mdhendri/Sprinkler/OpenSprinkler/JLPCB_BOM.xlsx

Comment | Designator | Footprint | JLCPCB Part #（optional）
10V 10uF X5R ±10% 0603 Multilayer Ceramic Capacitors MLCC - SMD/SMT ROHS | C7, C8, C9, C10, C13, C14, CS1 | 603 | C19702
 | C24 | 1206
4.7uF ±10% 0805 Multilayer Ceramic Capacitors MLCC - SMD/SMT ROHS | C25 | 805 | C576489
25V 22uF X5R ±20% 0805 Multilayer Ceramic Capacitors MLCC - SMD/SMT ROHS | C26 | 805 | C86816
1A 1kV 1.18V@2A SMA(DO-214AC) Diodes - General Purpose ROHS | D1, D2 | SMA(DO-214AC) | C47921
