mdhendri/Sprinkler/OpenSprinkler/OpenSprinkler.kicad_pcb

## KiCad design OpenSprinkler/OpenSprinkler.kicad_pcb (2025-02-17)

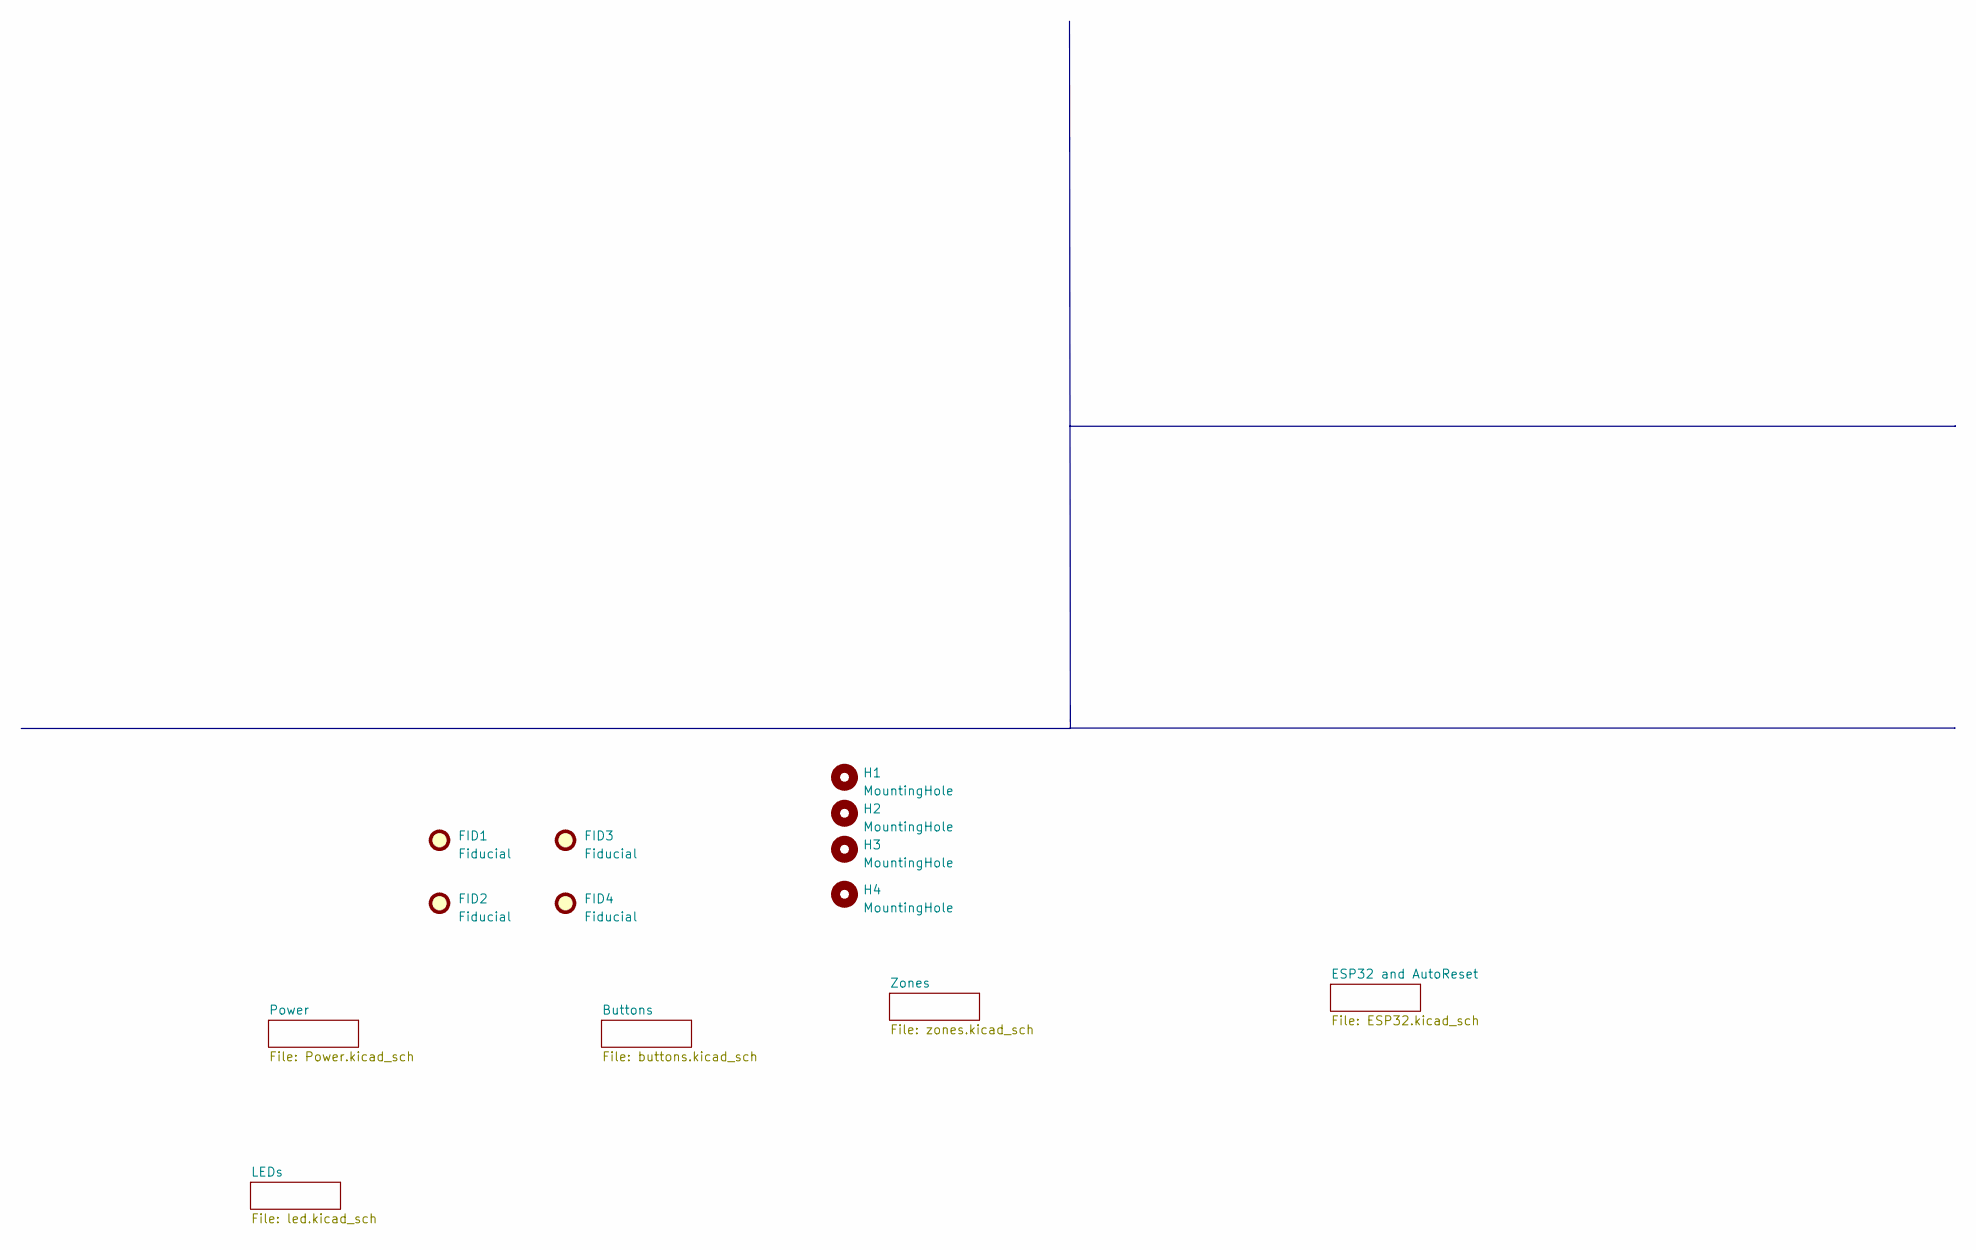
[picture p1: schematic OpenSprinkler.kicad_sch]

Parts:
FID1, FID2, FID3, FID4: Fiducial; Fiducial_0.5mm_Mask1.5mm
H1, H2, H3, H4: MountingHole; MountingHole_2.7mm

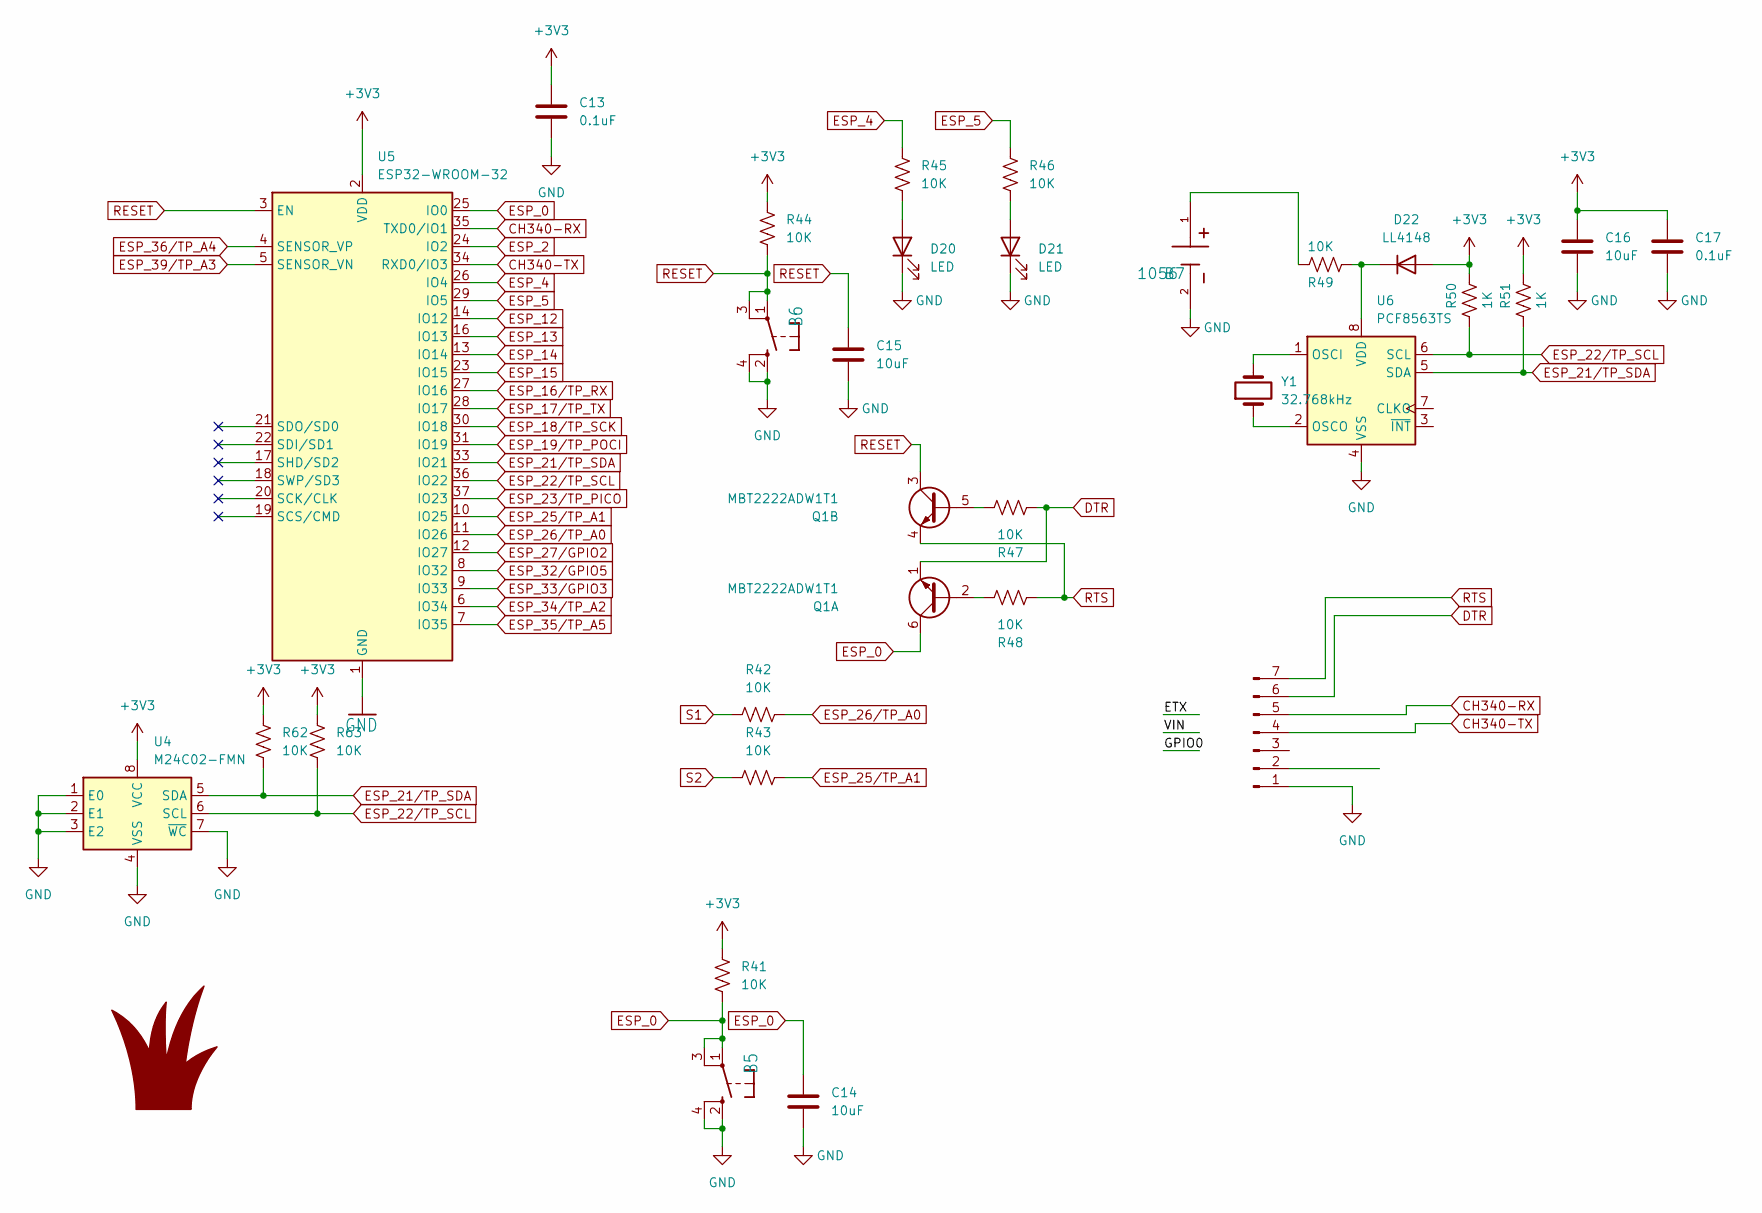
[picture p2: schematic ESP32.kicad_sch]

Parts:
B5, B6: SPST_TACTEVQQ2; SW_SPST_EVQQ2
B7: 1056; 1048P_KEY; PARTREV C
C13, C17: 0.1uF; C_0603_1608Metric_Pad1.08x0.95mm_HandSolder
C14, C15, C16: 10uF; C_0603_1608Metric_Pad1.08x0.95mm_HandSolder
D20, D21: LED; LED_0603_1608Metric_Pad1.05x0.95mm_HandSolder
D22: LL4148; D_MiniMELF
Q1: MBT2222ADW1T1; SOT-363_SC-70-6
R41, R42, R43, R44, R45, R46, R47, R48, R49, R62, R63: 10K; R_0603_1608Metric_Pad0.98x0.95mm_HandSolder
R50, R51: 1K; R_0603_1608Metric_Pad0.98x0.95mm_HandSolder
U4: M24C02-FMN; SOIC-8_3.9x4.9mm_P1.27mm
U5: ESP32-WROOM-32
U6: PCF8563TS; MSOP-8_3x3mm_P0.65mm
U$1: GOLDFINGER_2X3; PinHeader_1x07_P2.54mm_Vertical
Y1: 32.768kHz; XTAL_ECS-31B_ECS

Connections:
+3V3: C13.1, C16.1, C17.1, D22.2 (A), R41.1, R44.1, R50.1, R51.1, R62.1, R63.1, U4.8 (VCC), U5.2 (VDD); also elsewhere on the board
CH340-RX: U5.35 (TXD0/IO1), U$1.5
CH340-TX: U5.34 (RXD0/IO3), U$1.4
DTR: Q1.1 (E1), R47.1, U$1.6
ESP_0: B5.1, B5.3, C14.1, Q1.6 (C1), R41.2, U5.25 (IO0)
ESP_2: U5.24 (IO2)
ESP_4: R45.1, U5.26 (IO4)
ESP_5: R46.1, U5.29 (IO5)
ESP_12: U5.14 (IO12); also elsewhere on the board
ESP_13: U5.16 (IO13); also elsewhere on the board
ESP_14: U5.13 (IO14); also elsewhere on the board
ESP_15: U5.23 (IO15); also elsewhere on the board
ESP_16/TP_RX: U5.27 (IO16)
ESP_17/TP_TX: U5.28 (IO17)
ESP_18/TP_SCK: U5.30 (IO18)
ESP_19/TP_POCI: U5.31 (IO19)
ESP_21/TP_SDA: R51.2, R62.2, U4.5 (SDA), U5.33 (IO21), U6.5 (SDA); also elsewhere on the board
ESP_22/TP_SCL: R50.2, R63.2, U4.6 (SCL), U5.36 (IO22), U6.6 (SCL); also elsewhere on the board
ESP_23/TP_PICO: U5.37 (IO23)
ESP_25/TP_A1: R43.2, U5.10 (IO25)
ESP_26/TP_A0: R42.2, U5.11 (IO26)
ESP_27/GPIO2: U5.12 (IO27); also elsewhere on the board
ESP_32/GPIO5: U5.8 (IO32)
ESP_33/GPIO3: U5.9 (IO33)
ESP_34/TP_A2: U5.6 (IO34); also elsewhere on the board
ESP_35/TP_A5: U5.7 (IO35)
ESP_36/TP_A4: U5.4 (SENSOR_VP)
ESP_39/TP_A3: U5.5 (SENSOR_VN)
GND: B5.2, B5.4, B6.2, B6.4, B7.2, C13.2, C14.2, C15.2, C16.2, C17.2, D20.1 (K), D21.1 (K), U4.1 (E0), U4.2 (E1), U4.3 (E2), U4.4 (VSS), U4.7 (~WC), U5.1 (GND), U5.15 (GND), U5.38 (GND), U5.39 (GND), U6.4 (VSS), U$1.1; also elsewhere on the board
unnamed: B7.1, R49.1
unnamed: D20.2 (A), R45.2
unnamed: D21.2 (A), R46.2
unnamed: D22.1 (K), R49.2, U6.8 (VDD)
unnamed: Q1.2 (B1), R48.2
unnamed: Q1.5 (B2), R47.2
unnamed: U6.1 (OSCI), Y1.2
unnamed: U6.2 (OSCO), Y1.1
RESET: B6.1, B6.3, C15.1, Q1.3 (C2), R44.2, U5.3 (EN)
RTS: Q1.4 (E2), R48.1, U$1.7
S1: R42.1; also elsewhere on the board
S2: R43.1; also elsewhere on the board

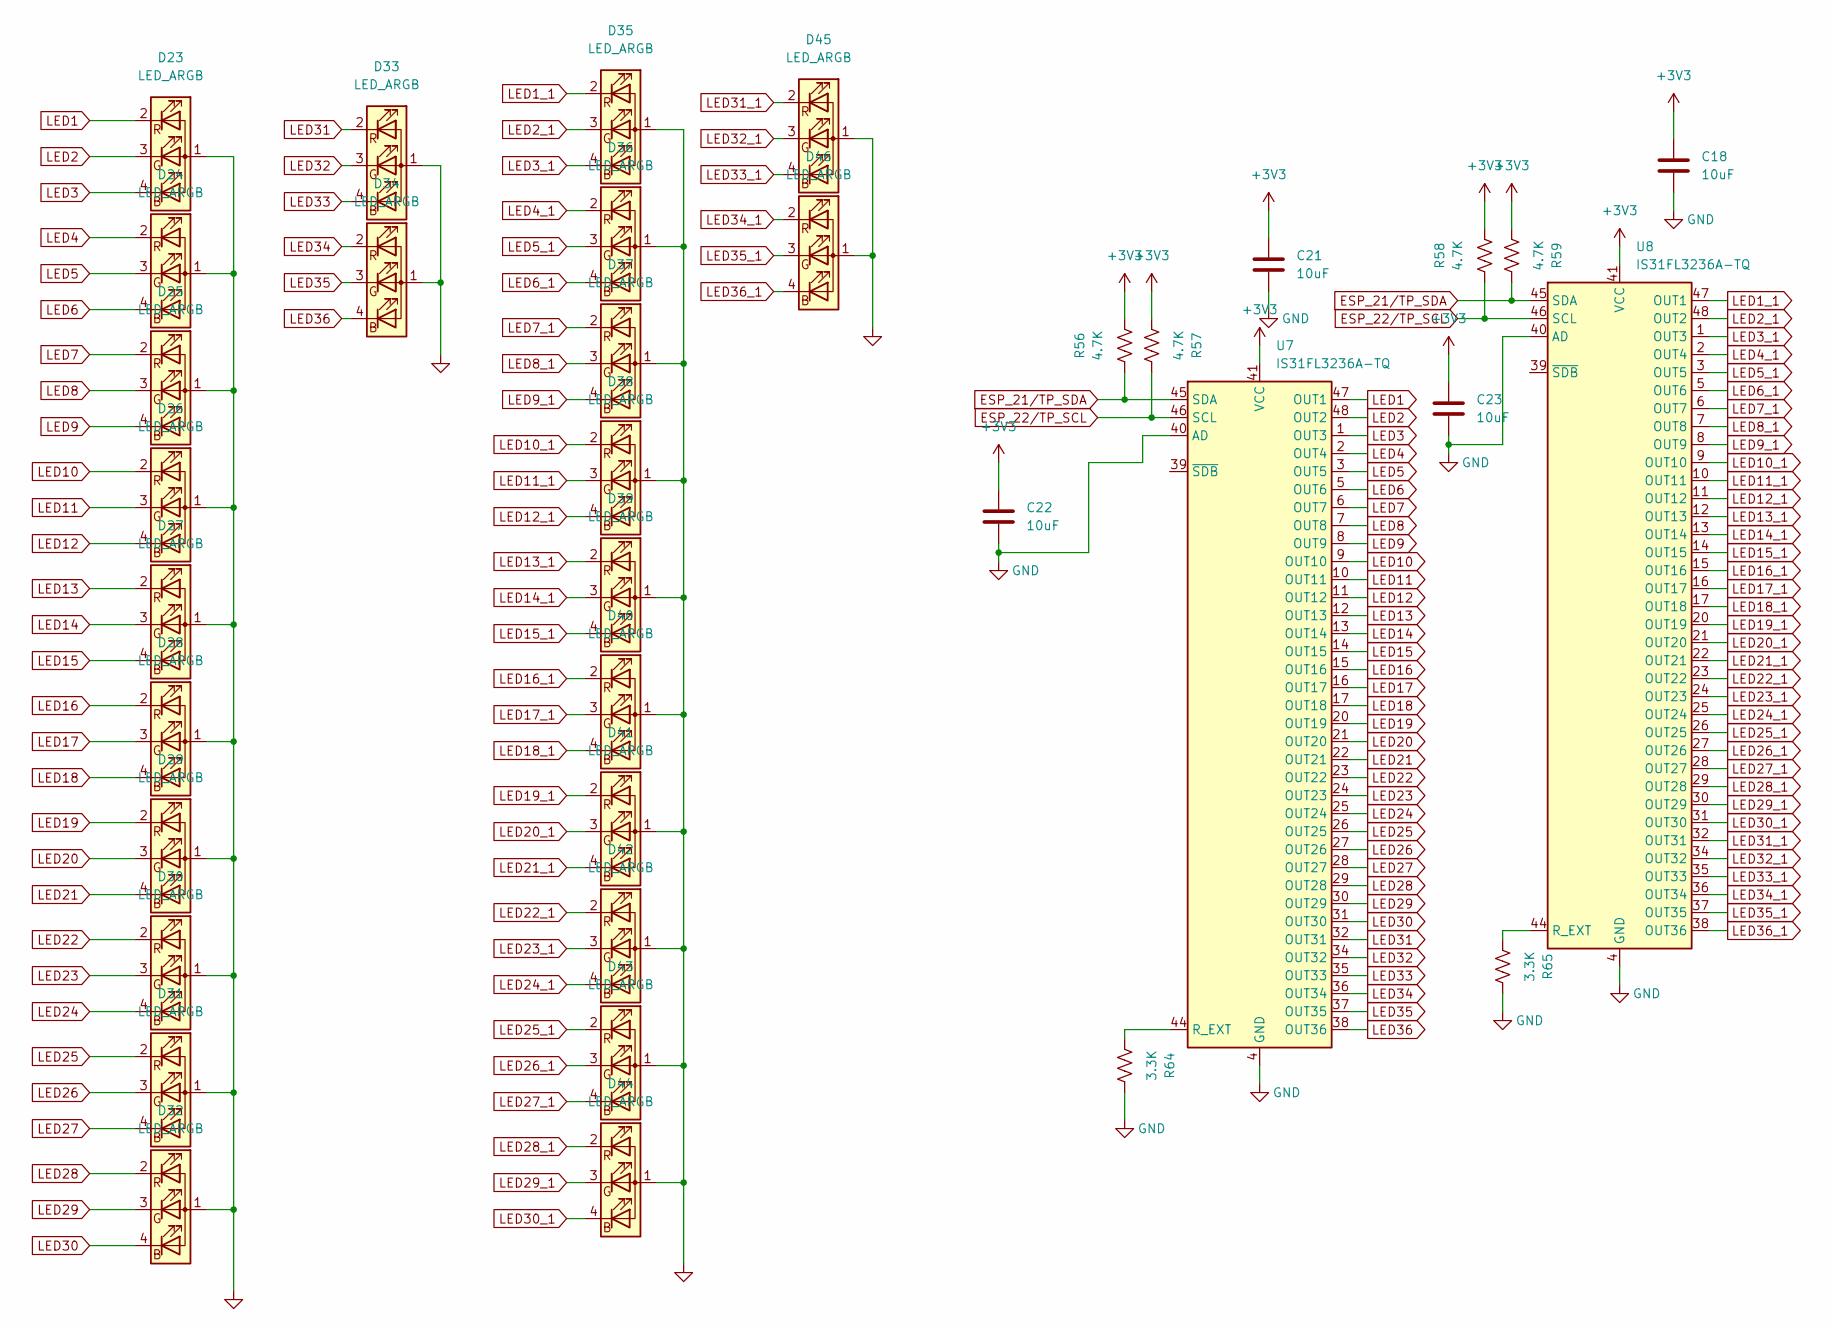
[picture p3: schematic led.kicad_sch]

Parts:
C18, C21, C22, C23: 10uF; C_0603_1608Metric_Pad1.08x0.95mm_HandSolder
D23, D24, D25, D26, D27, D28, D29, D30, D31, D32, D33, D34, D35, D36, D37, D38, D39, D40, D41, D42, D43, D44, D45, D46: LED_ARGB; LED_EASR3212RGBA0
R56, R57, R58, R59: 4.7K; R_0603_1608Metric_Pad0.98x0.95mm_HandSolder
R64, R65: 3.3K; R_0603_1608Metric_Pad0.98x0.95mm_HandSolder
U7, U8: IS31FL3236A-TQ; TQFP-48-1EP_7x7mm_P0.5mm_EP4.11x4.11mm

Connections:
+3V3: C18.1, C21.1, C22.1, C23.1, R56.2, R57.1, R58.2, R59.1, U7.41 (VCC), U8.41 (VCC); also elsewhere on the board
ESP_21/TP_SDA: R56.1, R59.2, U7.45 (SDA), U8.45 (SDA); also elsewhere on the board
ESP_22/TP_SCL: R57.2, R58.1, U7.46 (SCL), U8.46 (SCL); also elsewhere on the board
GND: C18.2, C21.2, C22.2, C23.2, D23.1 (A), D24.1 (A), D25.1 (A), D26.1 (A), D27.1 (A), D28.1 (A), D29.1 (A), D30.1 (A), D31.1 (A), D32.1 (A), D33.1 (A), D34.1 (A), D35.1 (A), D36.1 (A), D37.1 (A), D38.1 (A), D39.1 (A), D40.1 (A), D41.1 (A), D42.1 (A), D43.1 (A), D44.1 (A), D45.1 (A), D46.1 (A), R64.2, R65.2, U7.4 (GND), U7.18 (GND), U7.19 (GND), U7.33 (GND), U7.40 (AD), U7.42 (GND), U7.43 (GND), U7.49 (GND), U8.4 (GND), U8.18 (GND), U8.19 (GND), U8.33 (GND), U8.40 (AD), U8.42 (GND), U8.43 (GND), U8.49 (GND); also elsewhere on the board
LED1: D23.2 (RK), U7.47 (OUT1)
LED1_1: D35.2 (RK), U8.47 (OUT1)
LED2: D23.3 (GK), U7.48 (OUT2)
LED2_1: D35.3 (GK), U8.48 (OUT2)
LED3: D23.4 (BK), U7.1 (OUT3)
LED3_1: D35.4 (BK), U8.1 (OUT3)
LED4: D24.2 (RK), U7.2 (OUT4)
LED4_1: D36.2 (RK), U8.2 (OUT4)
LED5: D24.3 (GK), U7.3 (OUT5)
LED5_1: D36.3 (GK), U8.3 (OUT5)
LED6: D24.4 (BK), U7.5 (OUT6)
LED6_1: D36.4 (BK), U8.5 (OUT6)
LED7: D25.2 (RK), U7.6 (OUT7)
LED7_1: D37.2 (RK), U8.6 (OUT7)
LED8: D25.3 (GK), U7.7 (OUT8)
LED8_1: D37.3 (GK), U8.7 (OUT8)
LED9: D25.4 (BK), U7.8 (OUT9)
LED9_1: D37.4 (BK), U8.8 (OUT9)
LED10: D26.2 (RK), U7.9 (OUT10)
LED10_1: D38.2 (RK), U8.9 (OUT10)
LED11: D26.3 (GK), U7.10 (OUT11)
LED11_1: D38.3 (GK), U8.10 (OUT11)
LED12: D26.4 (BK), U7.11 (OUT12)
LED12_1: D38.4 (BK), U8.11 (OUT12)
LED13: D27.2 (RK), U7.12 (OUT13)
LED13_1: D39.2 (RK), U8.12 (OUT13)
LED14: D27.3 (GK), U7.13 (OUT14)
LED14_1: D39.3 (GK), U8.13 (OUT14)
LED15: D27.4 (BK), U7.14 (OUT15)
LED15_1: D39.4 (BK), U8.14 (OUT15)
LED16: D28.2 (RK), U7.15 (OUT16)
LED16_1: D40.2 (RK), U8.15 (OUT16)
LED17: D28.3 (GK), U7.16 (OUT17)
LED17_1: D40.3 (GK), U8.16 (OUT17)
LED18: D28.4 (BK), U7.17 (OUT18)
LED18_1: D40.4 (BK), U8.17 (OUT18)
LED19: D29.2 (RK), U7.20 (OUT19)
LED19_1: D41.2 (RK), U8.20 (OUT19)
LED20: D29.3 (GK), U7.21 (OUT20)
LED20_1: D41.3 (GK), U8.21 (OUT20)
LED21: D29.4 (BK), U7.22 (OUT21)
LED21_1: D41.4 (BK), U8.22 (OUT21)
LED22: D30.2 (RK), U7.23 (OUT22)
LED22_1: D42.2 (RK), U8.23 (OUT22)
LED23: D30.3 (GK), U7.24 (OUT23)
LED23_1: D42.3 (GK), U8.24 (OUT23)
LED24: D30.4 (BK), U7.25 (OUT24)
LED24_1: D42.4 (BK), U8.25 (OUT24)
LED25: D31.2 (RK), U7.26 (OUT25)
LED25_1: D43.2 (RK), U8.26 (OUT25)
LED26: D31.3 (GK), U7.27 (OUT26)
LED26_1: D43.3 (GK), U8.27 (OUT26)
LED27: D31.4 (BK), U7.28 (OUT27)
LED27_1: D43.4 (BK), U8.28 (OUT27)
LED28: D32.2 (RK), U7.29 (OUT28)
LED28_1: D44.2 (RK), U8.29 (OUT28)
LED29: D32.3 (GK), U7.30 (OUT29)
LED29_1: D44.3 (GK), U8.30 (OUT29)
LED30: D32.4 (BK), U7.31 (OUT30)
LED30_1: D44.4 (BK), U8.31 (OUT30)
LED31: D33.2 (RK), U7.32 (OUT31)
LED31_1: D45.2 (RK), U8.32 (OUT31)
LED32: D33.3 (GK), U7.34 (OUT32)
LED32_1: D45.3 (GK), U8.34 (OUT32)
LED33: D33.4 (BK), U7.35 (OUT33)
LED33_1: D45.4 (BK), U8.35 (OUT33)
LED34: D34.2 (RK), U7.36 (OUT34)
LED34_1: D46.2 (RK), U8.36 (OUT34)
LED35: D34.3 (GK), U7.37 (OUT35)
LED35_1: D46.3 (GK), U8.37 (OUT35)
LED36: D34.4 (BK), U7.38 (OUT36)
LED36_1: D46.4 (BK), U8.38 (OUT36)
unnamed: R64.1, U7.44 (R_EXT)
unnamed: R65.1, U8.44 (R_EXT)

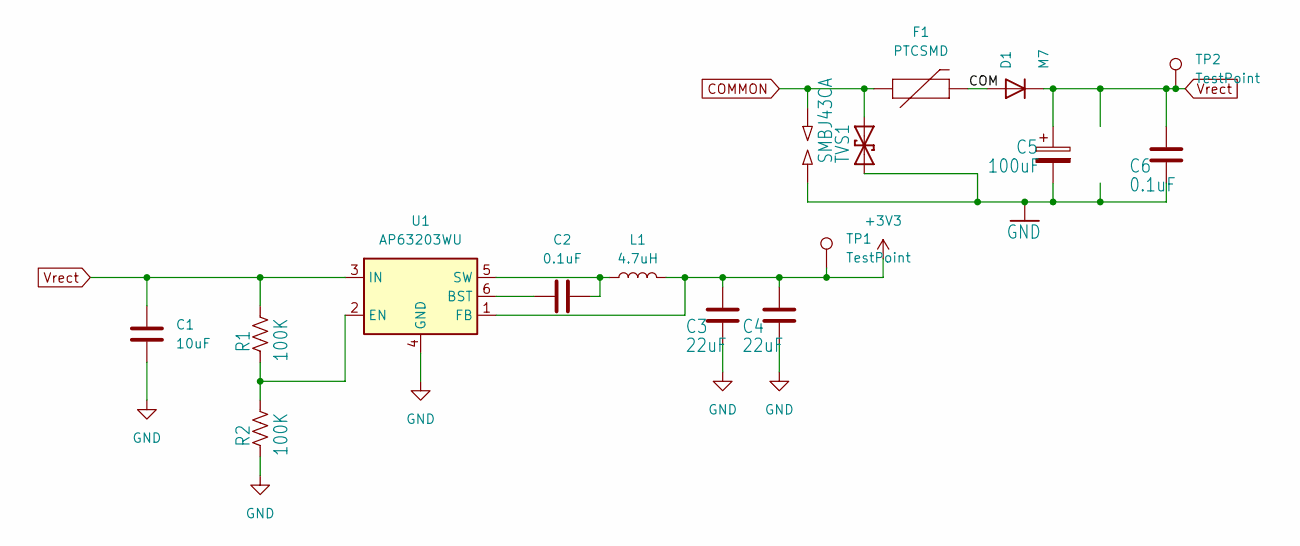
[picture p4: schematic Power.kicad_sch]

Parts:
C1: 10uF; C_1210_3225Metric_Pad1.33x2.70mm_HandSolder
C2: 0.1uF; C_0805_2012Metric_Pad1.18x1.45mm_HandSolder
C3, C4: 22uF; C_0805_2012Metric_Pad1.18x1.45mm_HandSolder
C5: 100uF; C_Elec_8x10.2
C6: 0.1uF; C_1206_3216Metric_Pad1.33x1.80mm_HandSolder
D1: M7; D_SMA
F1: PTCSMD; Fuse_Bourns_MF-SM_7.98x5.44mm
L1: 4.7uH; L_Abracon_ASPI-0425
R1, R2: 100K; R_0603_1608Metric_Pad0.98x0.95mm_HandSolder
SP1: PCB-SGAP; Sparkgap
TP1, TP2: TestPoint; TestPoint_Pad_D1.0mm
TVS1: SMBJ43CA; SMBJSeries_LTF
U1: AP63203WU; TSOT-23-6

Connections:
+3V3: C3.1, C4.1, L1.2, TP1.1, U1.1 (FB); also elsewhere on the board
/Power/COM: D1.2 (A), F1.2
COMMON: F1.1, SP1.2, TVS1.2 (C); also elsewhere on the board
GND: C1.2, C3.2, C4.2, C5.2, C6.2, R2.1, SP1.1, TVS1.1 (A), U1.4 (GND); also elsewhere on the board
unnamed: C2.1, U1.6 (BST)
unnamed: R1.1, R2.2, U1.2 (EN)
unnamed: C2.2, L1.1, U1.5 (SW)
Vrect: C1.1, C5.1, C6.1, D1.1 (K), R1.2, TP2.1, U1.3 (IN)

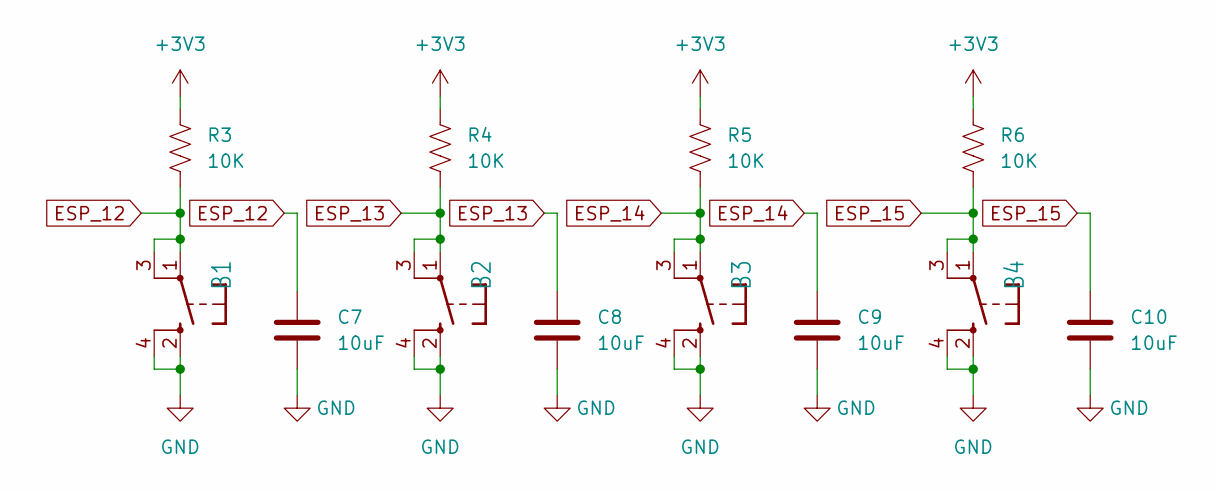
[picture p5: schematic buttons.kicad_sch]

Parts:
B1, B2, B3, B4: SPST_TACTEVQQ2; SW_SPST_EVQQ2
C7, C8, C9, C10: 10uF; C_0603_1608Metric_Pad1.08x0.95mm_HandSolder
R3, R4, R5, R6: 10K; R_0603_1608Metric_Pad0.98x0.95mm_HandSolder

Connections:
+3V3: R3.1, R4.1, R5.1, R6.1; also elsewhere on the board
ESP_12: B1.1, B1.3, C7.1, R3.2; also elsewhere on the board
ESP_13: B2.1, B2.3, C8.1, R4.2; also elsewhere on the board
ESP_14: B3.1, B3.3, C9.1, R5.2; also elsewhere on the board
ESP_15: B4.1, B4.3, C10.1, R6.2; also elsewhere on the board
GND: B1.2, B1.4, B2.2, B2.4, B3.2, B3.4, B4.2, B4.4, C7.2, C8.2, C9.2, C10.2; also elsewhere on the board

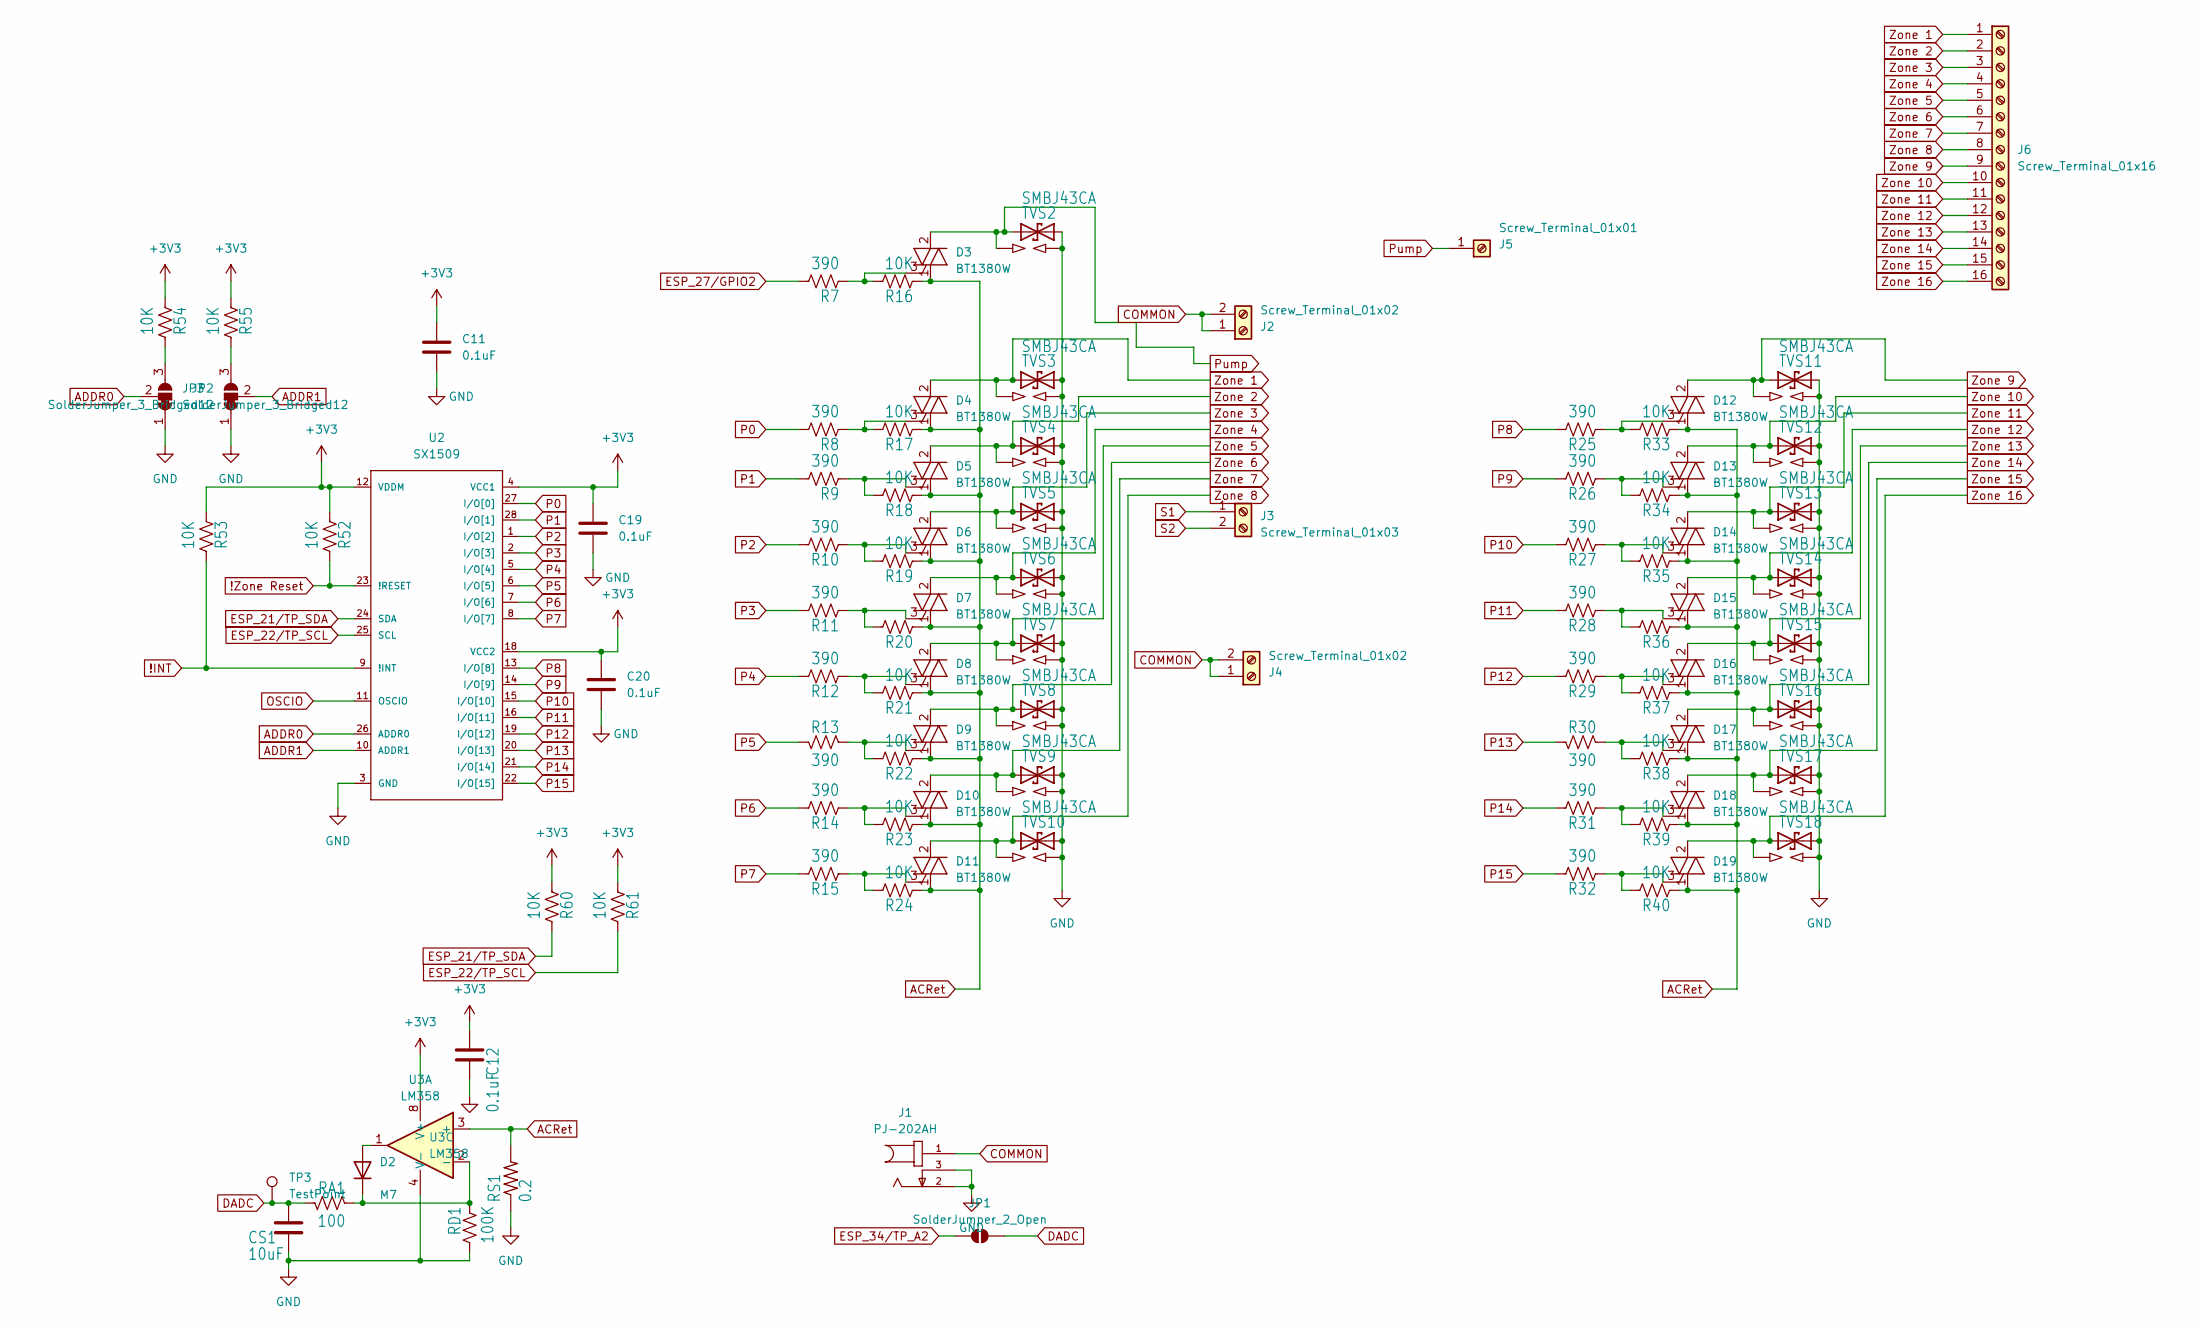
[picture p6: schematic zones.kicad_sch]

Parts:
C11, C12, C19, C20: 0.1uF; C_0603_1608Metric_Pad1.08x0.95mm_HandSolder
CS1: 10uF; C_0603_1608Metric_Pad1.08x0.95mm_HandSolder
D2: M7; D_SMA
D3, D4, D5, D6, D7, D8, D9, D10, D11, D12, D13, D14, D15, D16, D17, D18, D19: BT1380W; SOT-223
J1: PJ-202AH; BarrelJack_Kycon_KLDX-0202-xC_Horizontal; PART_REV 1.02
J2, J4: Screw_Terminal_01x02; TerminalBlock_WAGO_236-502_1x02_P7.50mm_45Degree
J3: Screw_Terminal_01x03; TerminalBlock_WAGO_236-502_1x02_P7.50mm_45Degree
J5: Screw_Terminal_01x01; TerminalBlock_WAGO_236-501_1x01_P7.50mm_45Degree
J6: Screw_Terminal_01x16; TerminalBlock_WAGO_236-516_1x16_P7.50mm_45Degree
JP1: SolderJumper_2_Open; SolderJumper-2_P1.3mm_Open_Pad1.0x1.5mm
JP2, JP3: SolderJumper_3_Bridged12; SolderJumper-3_P1.3mm_Bridged2Bar12_Pad1.0x1.5mm
R7, R8, R9, R10, R11, R12, R13, R14, R15, R25, R26, R27, R28, R29, R30, R31, R32: 390; R_0603_1608Metric_Pad0.98x0.95mm_HandSolder
R16, R17, R18, R19, R20, R21, R22, R23, R24, R33, R34, R35, R36, R37, R38, R39, R40, R52, R53, R54, R55, R60, R61: 10K; R_0603_1608Metric_Pad0.98x0.95mm_HandSolder
RA1: 100; R_0603_1608Metric_Pad0.98x0.95mm_HandSolder
RD1: 100K; R_0603_1608Metric_Pad0.98x0.95mm_HandSolder
RS1: 0.2; R_1206_3216Metric_Pad1.30x1.75mm_HandSolder
SP2, SP3, SP4, SP5, SP6, SP7, SP8, SP9, SP10, SP11, SP12, SP13, SP14, SP15, SP16, SP17, SP18: PCB-SGAP; Sparkgap
TP3: TestPoint; TestPoint_Pad_D1.0mm
TVS2, TVS3, TVS4, TVS5, TVS6, TVS7, TVS8, TVS9, TVS10, TVS11, TVS12, TVS13, TVS14, TVS15, TVS16, TVS17, TVS18: SMBJ43CA; D_SMB
U2: SX1509; QFN40P400X400X60-29N
U3: LM358; SOIC-8_3.9x4.9mm_P1.27mm

Connections:
!INT: R53.2, U2.9 (!INT)
!Zone Reset: R52.2, U2.23 (!RESET)
+3V3: C11.1, C12.1, C19.1, C20.1, R52.1, R53.1, R54.1, R55.1, R60.1, R61.1, U2.4 (VCC1), U2.12 (VDDM), U2.18 (VCC2), U3.8 (V+); also elsewhere on the board
ACRet: D3.1 (A1), D4.1 (A1), D5.1 (A1), D6.1 (A1), D7.1 (A1), D8.1 (A1), D9.1 (A1), D10.1 (A1), D11.1 (A1), D12.1 (A1), D13.1 (A1), D14.1 (A1), D15.1 (A1), D16.1 (A1), D17.1 (A1), D18.1 (A1), D19.1 (A1), R16.1, R17.1, R18.1, R19.1, R20.1, R21.1, R22.1, R23.1, R24.1, R33.1, R34.1, R35.1, R36.1, R37.1, R38.1, R39.1, R40.1, RS1.2, U3.3 (+)
ADDR0: JP3.2 (C), U2.26 (ADDR0)
ADDR1: JP2.2 (C), U2.10 (ADDR1)
COMMON: J1.1, J2.1, J2.2, J4.1, J4.2; also elsewhere on the board
DADC: CS1.1, JP1.2 (B), RA1.2, TP3.1
ESP_21/TP_SDA: R60.2, U2.24 (SDA); also elsewhere on the board
ESP_22/TP_SCL: R61.2, U2.25 (SCL); also elsewhere on the board
ESP_27/GPIO2: R7.2; also elsewhere on the board
ESP_34/TP_A2: JP1.1 (A); also elsewhere on the board
GND: C11.2, C12.2, C19.2, C20.2, CS1.2, J1.2, J1.3, JP2.1 (A), JP3.1 (A), RD1.1, RS1.1, SP2.2, SP3.2, SP4.2, SP5.2, SP6.2, SP7.2, SP8.2, SP9.2, SP10.2, SP11.2, SP12.2, SP13.2, SP14.2, SP15.2, SP16.2, SP17.2, SP18.2, TVS2.2 (C), TVS3.2 (C), TVS4.2 (C), TVS5.2 (C), TVS6.2 (C), TVS7.2 (C), TVS8.2 (C), TVS9.2 (C), TVS10.2 (C), TVS11.2 (C), TVS12.2 (C), TVS13.2 (C), TVS14.2 (C), TVS15.2 (C), TVS16.2 (C), TVS17.2 (C), TVS18.2 (C), U2.3 (GND), U2.17 (GND), U2.29 (GND), U3.4 (V-); also elsewhere on the board
unnamed: D2.2 (A), U3.1
unnamed: D2.1 (K), RA1.1, RD1.2, U3.2 (-)
unnamed: D3.3 (G), R7.1, R16.2
unnamed: D4.3 (G), R8.1, R17.2
unnamed: D5.3 (G), R9.1, R18.2
unnamed: D6.3 (G), R10.1, R19.2
unnamed: D7.3 (G), R11.1, R20.2
unnamed: D8.3 (G), R12.1, R21.2
unnamed: D9.3 (G), R13.1, R22.2
unnamed: D10.3 (G), R14.1, R23.2
unnamed: D11.3 (G), R15.1, R24.2
unnamed: D12.3 (G), R25.1, R33.2
unnamed: D13.3 (G), R26.1, R34.2
unnamed: D14.3 (G), R27.1, R35.2
unnamed: D15.3 (G), R28.1, R36.2
unnamed: D16.3 (G), R29.1, R37.2
unnamed: D17.3 (G), R30.1, R38.2
unnamed: D18.3 (G), R31.1, R39.2
unnamed: D19.3 (G), R32.1, R40.2
unnamed: JP2.3 (B), R55.2
unnamed: JP3.3 (B), R54.2
OSCIO: U2.11 (OSCIO)
P0: R8.2, U2.27 (I/O[0])
P1: R9.2, U2.28 (I/O[1])
P2: R10.2, U2.1 (I/O[2])
P3: R11.2, U2.2 (I/O[3])
P4: R12.2, U2.5 (I/O[4])
P5: R13.2, U2.6 (I/O[5])
P6: R14.2, U2.7 (I/O[6])
P7: R15.2, U2.8 (I/O[7])
P8: R25.2, U2.13 (I/O[8])
P9: R26.2, U2.14 (I/O[9])
P10: R27.2, U2.15 (I/O[10])
P11: R28.2, U2.16 (I/O[11])
P12: R29.2, U2.19 (I/O[12])
P13: R30.2, U2.20 (I/O[13])
P14: R31.2, U2.21 (I/O[14])
P15: R32.2, U2.22 (I/O[15])
Pump: D3.2 (A2), D3.4 (A4), J5.1, SP2.1, TVS2.1 (A)
S1: J3.1; also elsewhere on the board
S2: J3.2; also elsewhere on the board
Zone 1: D4.2 (A2), D4.4 (A4), J6.1, SP3.1, TVS3.1 (A)
Zone 2: D5.2 (A2), D5.4 (A4), J6.2, SP4.1, TVS4.1 (A)
Zone 3: D6.2 (A2), D6.4 (A4), J6.3, SP5.1, TVS5.1 (A)
Zone 4: D7.2 (A2), D7.4 (A4), J6.4, SP6.1, TVS6.1 (A)
Zone 5: D8.2 (A2), D8.4 (A4), J6.5, SP7.1, TVS7.1 (A)
Zone 6: D9.2 (A2), D9.4 (A4), J6.6, SP8.1, TVS8.1 (A)
Zone 7: D10.2 (A2), D10.4 (A4), J6.7, SP9.1, TVS9.1 (A)
Zone 8: D11.2 (A2), D11.4 (A4), J6.8, SP10.1, TVS10.1 (A)
Zone 9: D12.2 (A2), D12.4 (A4), J6.9, SP11.1, TVS11.1 (A)
Zone 10: D13.2 (A2), D13.4 (A4), J6.10, SP12.1, TVS12.1 (A)
Zone 11: D14.2 (A2), D14.4 (A4), J6.11, SP13.1, TVS13.1 (A)
Zone 12: D15.2 (A2), D15.4 (A4), J6.12, SP14.1, TVS14.1 (A)
Zone 13: D16.2 (A2), D16.4 (A4), J6.13, SP15.1, TVS15.1 (A)
Zone 14: D17.2 (A2), D17.4 (A4), J6.14, SP16.1, TVS16.1 (A)
Zone 15: D18.2 (A2), D18.4 (A4), J6.15, SP17.1, TVS17.1 (A)
Zone 16: D19.2 (A2), D19.4 (A4), J6.16, SP18.1, TVS18.1 (A)

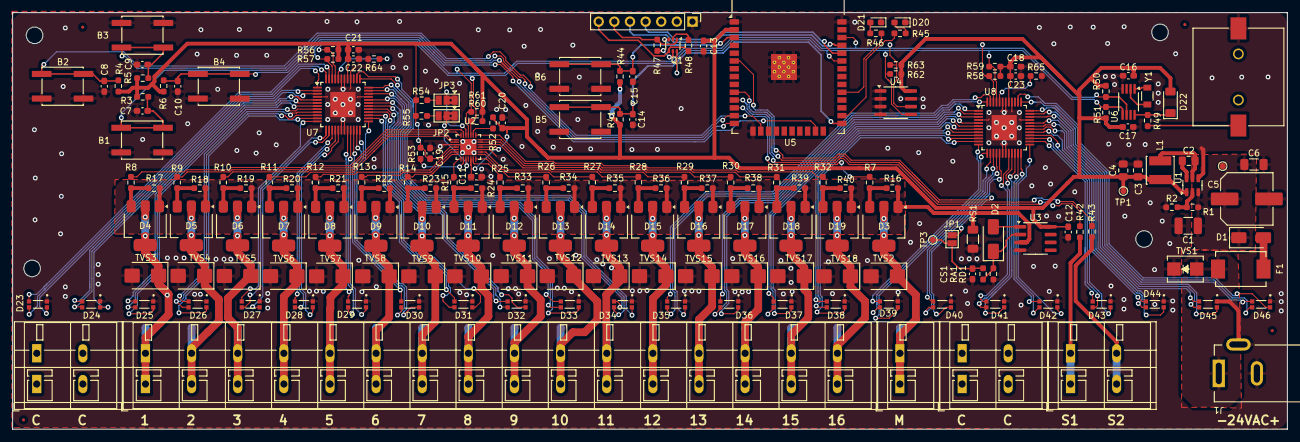
[picture p7: board OpenSprinkler.kicad_pcb from above]

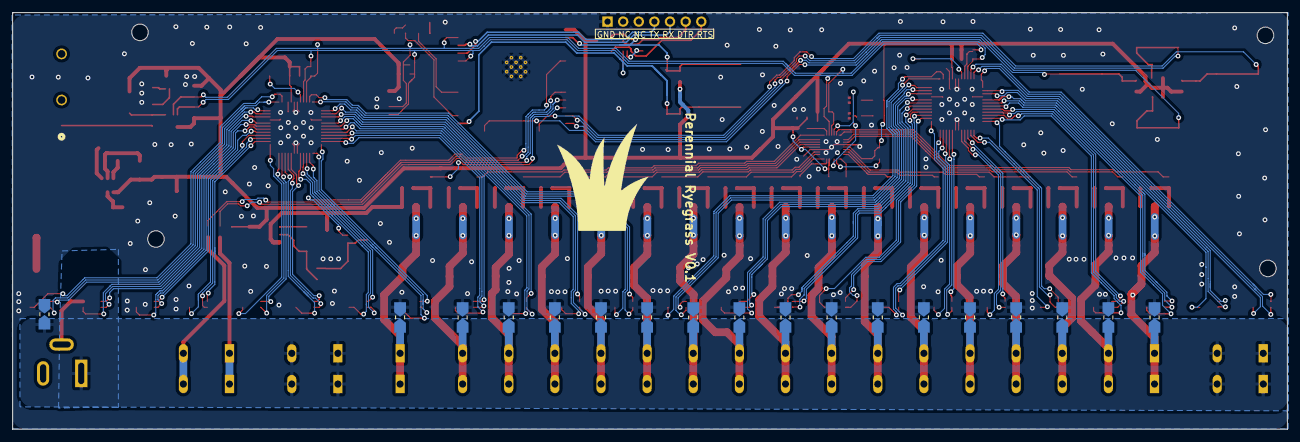
[picture p8: board OpenSprinkler.kicad_pcb from below]

Board: 2 copper layers, 207.3 x 67.7 mm, 214 parts (18 on the bottom side), 170 nets.
