mdhendri/Sprinkler/(commit log)

2025-01-22 fixing connector
    [ESP32.kicad_sch, OpenSprinkler.kicad_pcb, Power.kicad_sch, zones.kicad_sch]
2025-02-17 Updating pcb
    [OpenSprinkler.kicad_pcb]
